jakovsola/BodyBasher/readme.txt

The Body Basher repository: everything you need to build your own affordable body biasing injection tool.
