jakovsola/BodyBasher/Firmware/readme.txt

Notes:
- build the project in release mode
- can use flash.bat to flash the Body Basher using the STM32 Programmer CLI, edit paths accordingly
