jakovsola/BodyBasher/ProductionFiles/Assembly/BOM.xlsx

Designator | Quantity | VALUE_4C | MANUFCODE | MANUF | DESCR | POPULATE
3V3, 5V, 12V, AGND, COM_N, COM_P, EN_BB, EN_MD, EN_SW, MISO, nCS, nFLT, SCK, SCL, SDA, SET, TP400, TP401, TP402, TP403, USB_M, USB_P, V_MEAS, VBUS, VCTRL, VDDIN | 26 |  | TP |  | TESTPOINT 1.5MM | NA
BOOT, COM, PULSE, TRIG, V_READY | 5 |  | 2MM-HB-S02-VT-02-H-TB | TE CONNECTIVITY | CON 2P 2MM HEADER | YES
C100 | 1 | 01N0 | 2238 600 15623 | PHYCOMP | CAP 01N0 0805 100V X7R 10% | YES
C200, C201, C202, C203, C204, C300, C301, C400, C401, C404, C405, C500, C502, C602, C605, C607, C608, C610 | 18 | 100N | CL10B104KA8WPNC | SAMSUNG | CAP 100N 0603 25V X7R 10% | YES
C205 | 1 | 04U7 | CL31B475KBHNNNE | SAMSUNG | CAP 04U7 1206 50V X7R 10% | YES
C206, C501 | 2 | 10N0 | C0603C103K8RACTU | KEMET | CAP 10N0 0603 10V X7R 10% | YES
C207, C606, C609 | 3 | 01U0 | C0603C105K4PAC-TU | KEMET | CAP 01U0 0603 16V X5R 10% | YES
C208 | 1 | 22N0 | C0603C223K8RAC7867 | KEMET | CAP 22N0 0603 10V X7R 10% | YES
C209, C210 | 2 | 15P0 | C0603C150K8RAC | KEMET | CAP 15P0 0603 10V X7R 10% | DNP
C402 | 1 | 10N0 | CGA3E2C0G1H103J080AA | TDK | CAP 10N0 0603 50V NP0 5% | YES
C403 | 1 | 33N0 | CL10B333KB8NFNC | SAMSUNG | CAP 33N0 0603 50V X7R 10% | YES
C503, C612, C618 | 3 | 01U0 | C0603C105K3PAC | KEMET | CAP 01U0 0603 25V X5R 10% | YES
C504, C505, C506, C507, C508, C509, C510, C511, C512, C513 | 10 | 01U0 | 2220CC105KAZ2A | KOYCERA | CAP 01U0 2220 600V X7R 10% | DNP
C600, C601 | 2 | 10U0 | ZRB18AR61E106ME01L | MURATA | CAP 10U0 0603 25V X5R 20% | YES
C603 | 1 | 220N | AC0603KRX7R6BB224 | YAGEO | CAP 220N 0603 10V X7R 10% | YES
C604 | 1 | 01N0 | 1206AC102KAT2A | AVX | CAP 01N0 1206 1KV X7R 10% | YES
C611 | 1 | 22U0 | CL31A226KAHNNNE | SAMSUNG | CAP 22U0 1206 25V X5R 10% | YES
C613 | 1 | 10U0 | TAJC106K025RNJ | AVX | CAP 10U0 C 25V TANT 10% | YES
C614 | 1 | 04U7 | GRM185R61C475KE11D | MURATA | CAP 04U7 0603 16V X5R 10% | YES
C615 | 1 | 56U0 | 20SVPF56MX | PANASONIC | CAP 56U0 5X5.9 20V 20% | DNP
C616 | 1 | 01U0 | C0603C105K3PAC | KEMET | CAP 01U0 0603 25V X5R 10% | DNP
C617 | 1 | 68N0 | C0603C683K8RACTU | KEMET | CAP 68N0 0603 10V X7R 10% | YES
C619, C620, C621 | 3 | 33U0 | C3216X5R1E336M160AC | TDK | CAP 33U0 1206 25V X5R 20% | YES
C622 | 1 | 56U0 | 20SVPF56MX | PANASONIC | CAP 56U0 5X5.9 20V 20% | YES
C_BANK | 1 | 10U0 | B32928A4106K000 | EPCOS | CAP 10U 30X58 650V PP 10% | YES
CON_PWR | 1 |  | 1711725 | PHOENIX CONTACT | CON PHOENIX 5.08MM 2P SCREW | YES
D1, D2, PWR | 3 |  | ASMT-RF45 | AVAGO TECHNOLOGIES | LED GREEN 0603 20MA 2.4V 60MCD | YES
D601 | 1 |  | RS2K-E3/52T | VISHAY | DIODE 800V 1.5A SMB | YES
IC200 | 1 |  | STM32F072CBT6 | STM | IC MCU ARM CORTEX-M0 128KB 48MHZ USB | YES
IC300 | 1 |  | SN74LVC257APWR | TI | IC MUX QUAD 2:1 3 STATE | YES
IC301 | 1 |  | 74LVC1GU04GW,125 | NEXPERIA | IC INV SINGLE UNBUFFERED | YES
IC400, IC401 | 2 |  | ISO7741FBDW | TI | IC ISO 3/1 100MBPS 2.25-5.5 V | YES
IC402 | 1 |  | LMG2610RRGT | TEXAS INSTRUMENTS | IC INT HALF BRIDGE GAN | YES
IC403, IC404 | 2 |  | CPC1981Y | IXYS | IC SSR SPST NO 1000V 180mA | YES
IC500 | 1 |  | PLB171P | IXYS | IC SSR SPST NC 800V 80mA | YES
IC501 | 1 |  | ADC101S051CIMF/NOPB | TI | IC ADC 10B 500KSPS SPI | YES
IC502 | 1 |  | OPA310IDCKR | TI | IC OPAMP 5.5V 3MHz | YES
IC600 | 1 |  | MIC2954-03WS-TR | MICROCHIP | IC LDO 2-30VIN 5VOUT 250mA | YES
IC601 | 1 |  | TPS55289RYQR | TI | IC BUCK-BOOST 30V 8A I2C | YES
L600 | 1 |  | SRN8040-4R7Y | BOURNS | INDUCTOR 04U7 4A1 R024 SMD | YES
PIN | 1 |  | P25-0123 | HARWIN | POGO PIN 15X5MM | YES
R100 | 1 | 33K0 | CRCW060333K0FKEA | VISHAY | RES 33K0 0603 0.1W 1% 75V 100PPM | YES
R101, R102, R105 | 3 | 33R0 | CRCW060333R0FKEA | VISHAY | RES 33R0 0603 0.1W 1% 75V 100PPM | YES
R103 | 1 | 82K0 | CRCW060382K0FKEA | VISHAY | RES 82K0 0603 0.1W 1% 75V 100PPM | YES
R104 | 1 | 01M0 | MC 0.063W 0603 1% 1M | MULTICOMP | RES 01M0 0603 0.063W 1% 50V 100PPM | YES
R200, R201 | 2 | 10K0 | CRCW060310K0FKEA | VISHAY | RES 10K0 0603 0.1W 1% 75V 100PPM | YES
R202 | 1 | 13K3 | CRCW060313K3FKEA | VISHAY | RES 13K3 0603 0.1W 1% 75V 100PPM | YES
R203, R204, R206, R207 | 4 | 01K0 | MC 0.063W 0603 1% 1K | MULTICOMP | RES 01K0 0603 0.063W 1% 50V 100PPM | YES
R205 | 1 | 05K1 | RC0603FR-075K1L | YAGEO | RES 05K1 0603 0.1W 1% 75V 100PPM | YES
R208, R209, R210 | 3 | 000R | CRCW06030000Z0EA | VISHAY | RES 000R 0603 0.1W 1% 75V 100PPM | DNP
R211 | 1 | 470R | ERA3AEB471V | PANASONIC | RES 470R 0603 0.1W 0.1% 75V 25PPM | DNP
R400 | 1 | 05K1 | MC 0.063W 0603 1% 5K1 | MULTICOMP | RES 05K1 0603 0.063W 1% 50V 100PPM | YES
R401, R402 | 2 | 05K6 | MC 0.063W 0603 1% 5K6 | MULTICOMP | RES 05K6 0603 0.063W 1% 50V 100PPM | YES
R403, R404, R500 | 3 | 120R | CRCW0603120RFKEA | VISHAY | RES 120R 0603 0.1W 1% 75V 100PPM | YES
R501 | 1 | 100M | CRHA1210AF100MFKEF | VISHAY | RES 100M 1210 0.45W 1% 1750V 100PPM | YES
R502 | 1 | 01M0 | RCV12061M00FKEAAT | VISHAY | RES 1M 1210 0.25W 1% 800V 100PPM | YES
R600 | 1 | 04K7 | CRCW06034K70JNEAC | VISHAY | RES 04K7 0603 0.1W 5% 75V 200PPM | YES
R601 | 1 | 680K | CRCW0603680KFKEA | VISHAY | RES 680K 0603 0.1W 1% 75V 100PPM | DNP
R602 | 1 | 100K | MC 0.063W 0603 1% 100K | MULTICOMP | RES 100K 0603 0.063W 1% 50V 100PPM | YES
R603 | 1 | 10K5 | MC0063W0603110K5 | MULTICOMP | RES 10K5 0603 0.063W 1% 50V 100PPM | YES
R604 | 1 | 000R | CRCW06030000Z0EA | VISHAY | RES 000R 0603 0.1W 1% 75V 100PPM | YES
R605 | 1 | 100K | MC 0.063W 0603 1% 100K | MULTICOMP | RES 100K 0603 0.063W 1% 50V 100PPM | DNP
R606 | 1 | 47K0 | CRCW060347K0FKEA | VISHAY | RES 47K0 0603 0.1W 1% 75V 100PPM | YES
R607 | 1 | 1K10 | CRCW06031K10FKEA | VISHAY | RES 1K10 0603 0.1W 1% 75V 100PPM | DNP
R608 | 1 | 4K99 | MC 0.063W 0603 1% 4K99 | MULTICOMP | RES 4K99 0603 0.1W 1% 50V 100PPM | YES
R_BLEED | 1 | 25K0 | RS01025K00FE73 | VISHAY | RES 25K AXIAL 10W 1% 20PPM | YES
RST | 1 |  | FSM2JSMAATR | TE CONNECTIVITY | BTN 24V 4P SMD | YES
TR600 | 1 |  | TMR 1-1212 | TRACO | IC TR 9-18 VIN 12 VOUT REG ISO 1W | YES
TR601 | 1 |  | TSR 0.5-2433 | TRACO | IC TR 4.75-32 VIN 3.3 VOUT 0.5A | YES
TR602 | 1 |  | TDU 1-1212 | TRACO | IC TR 10.8-13.2 VIN 12 VOUT ISO 1W | YES
TVS100 | 1 |  | SP3003-02JTG | LITTELFUSE | DIODE TVS DUAL 0.65PF SC70-5 | YES
USB | 1 |  | 47642-0001 | MOLEX | CON MICRO USB 5P SMD | YES
X200 | 1 |  | ABS07-32.768KHZ-7-T | ABRACON | CRYSTAL 32.768KHZ 7PF 20PPM SMD | DNP
X201 | 1 |  | FC3BAEBDI8.0-T1 | ABRACON | CRYSTAL 8MHZ 8PF 20PPM SMD | DNP
XP600 | 1 |  | F05 | XP POWER | IC DCDC 0.8-12VIN 0-500 VOUT 10W | YES
