jakovsola/BodyBasher/Documents/Schematic.pdf

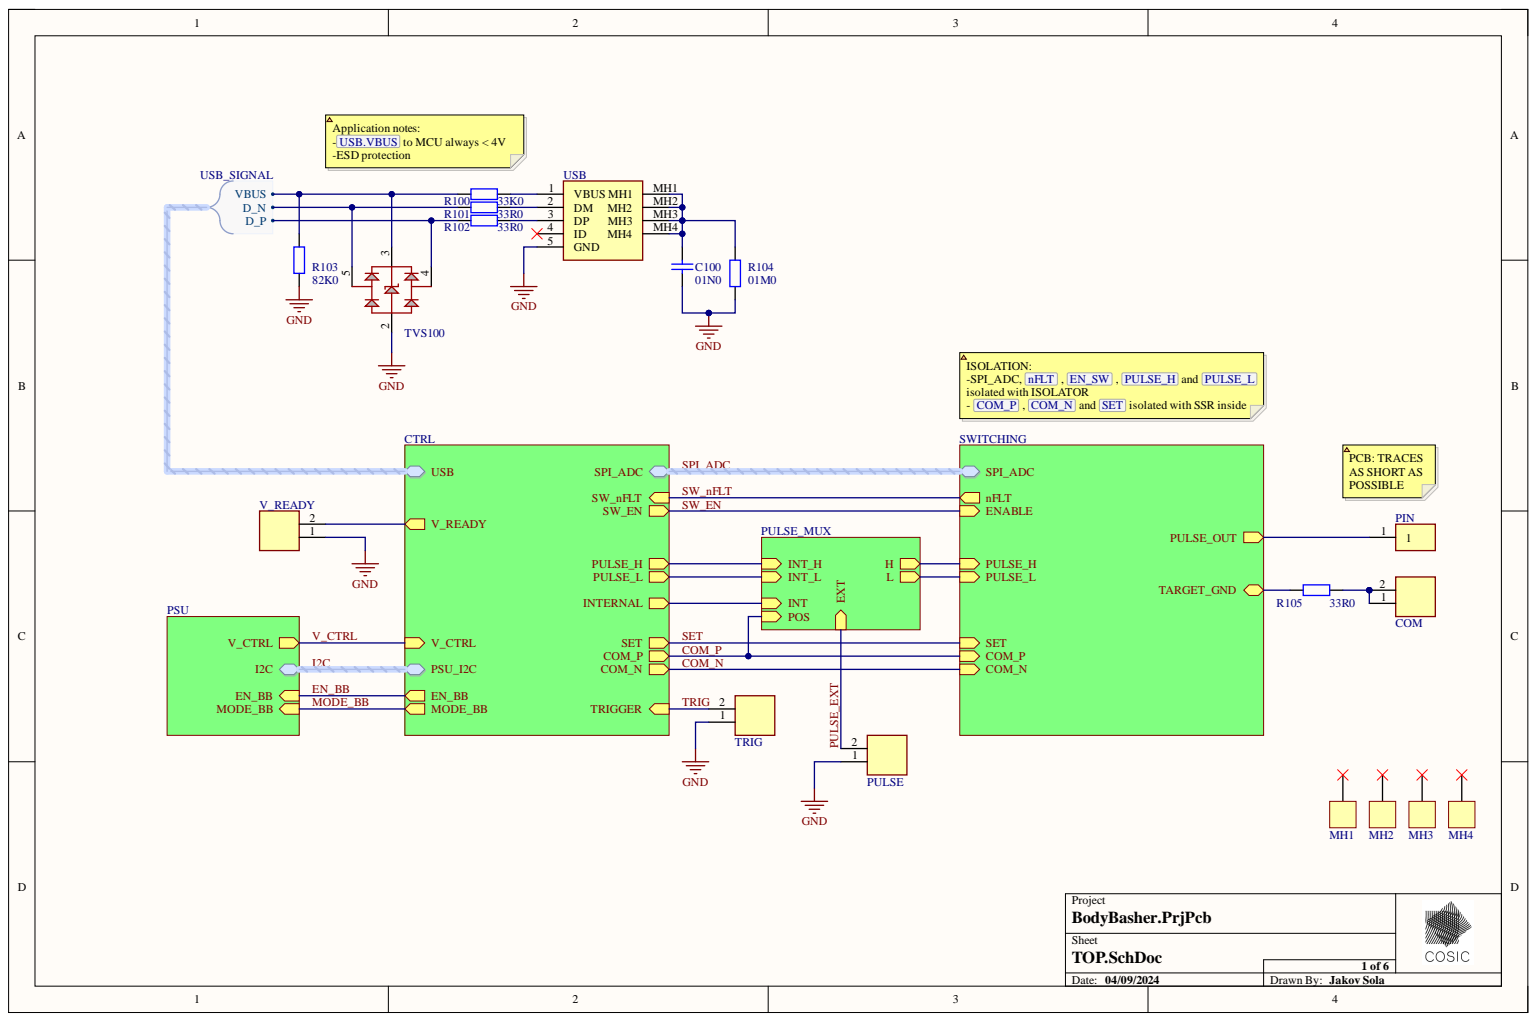
[picture p2: page 1]

Application notes:
- USB.VBUS to MCU always < 4V
-ESD protection

ISOLATION:
-SPI_ADC, nFLT , EN_SW , PULSE_H and PULSE_L
isolated with ISOLATOR
- COM_P , COM_N and SET isolated with SSR inside

I2C | COM_P

COM_N

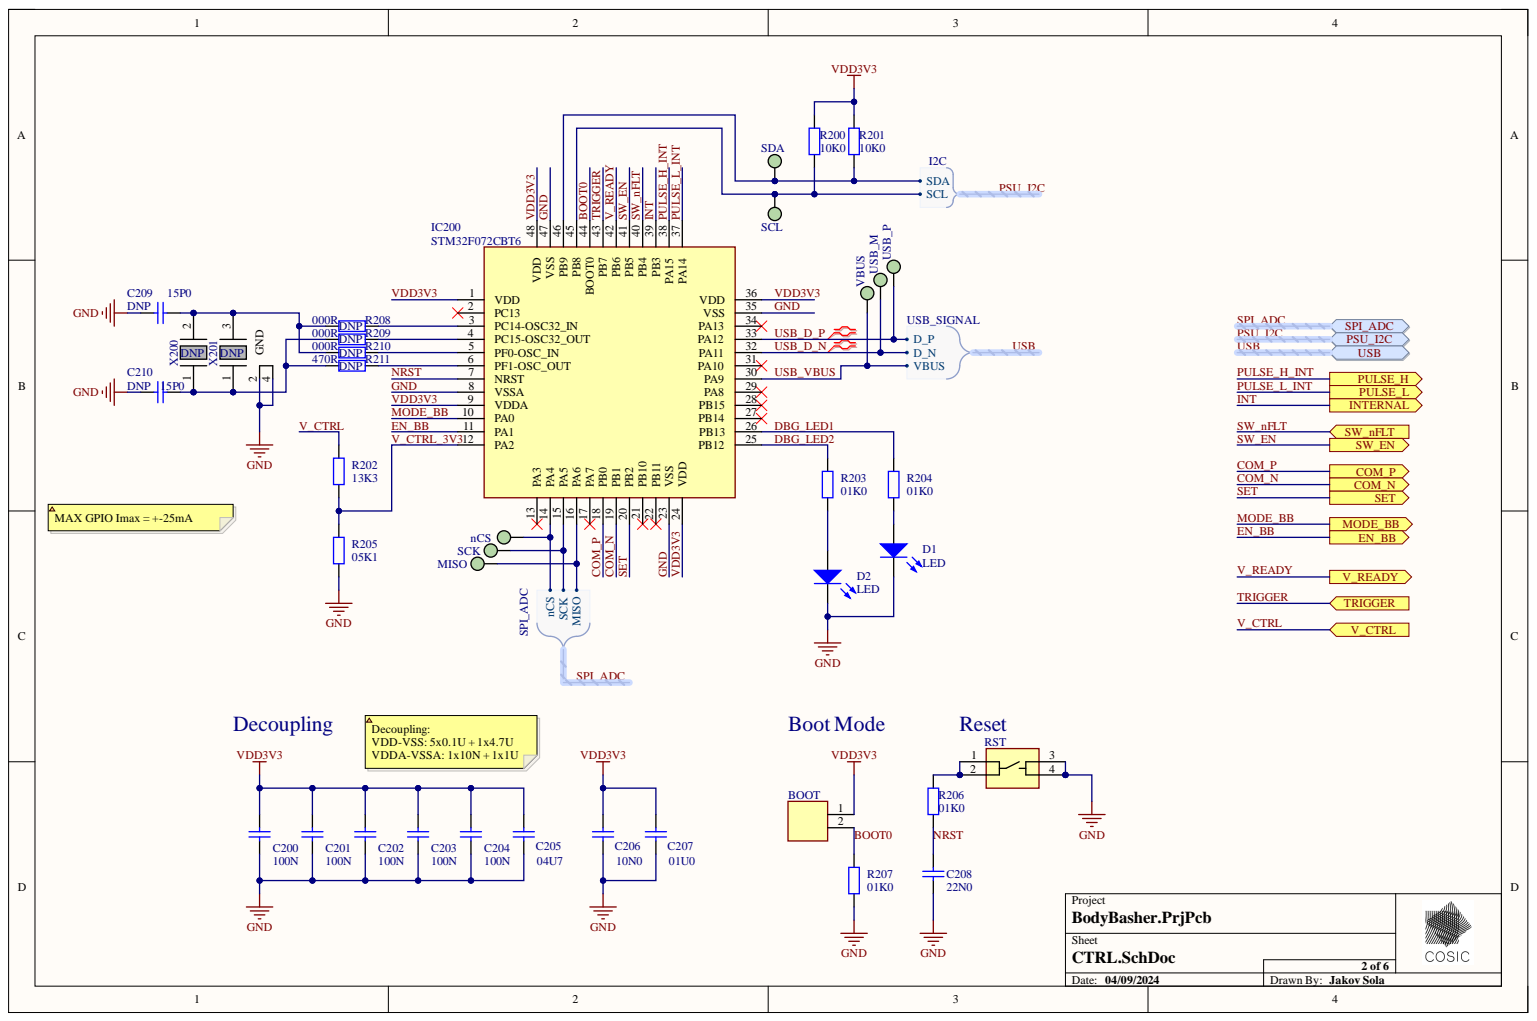
[picture p3: page 2]

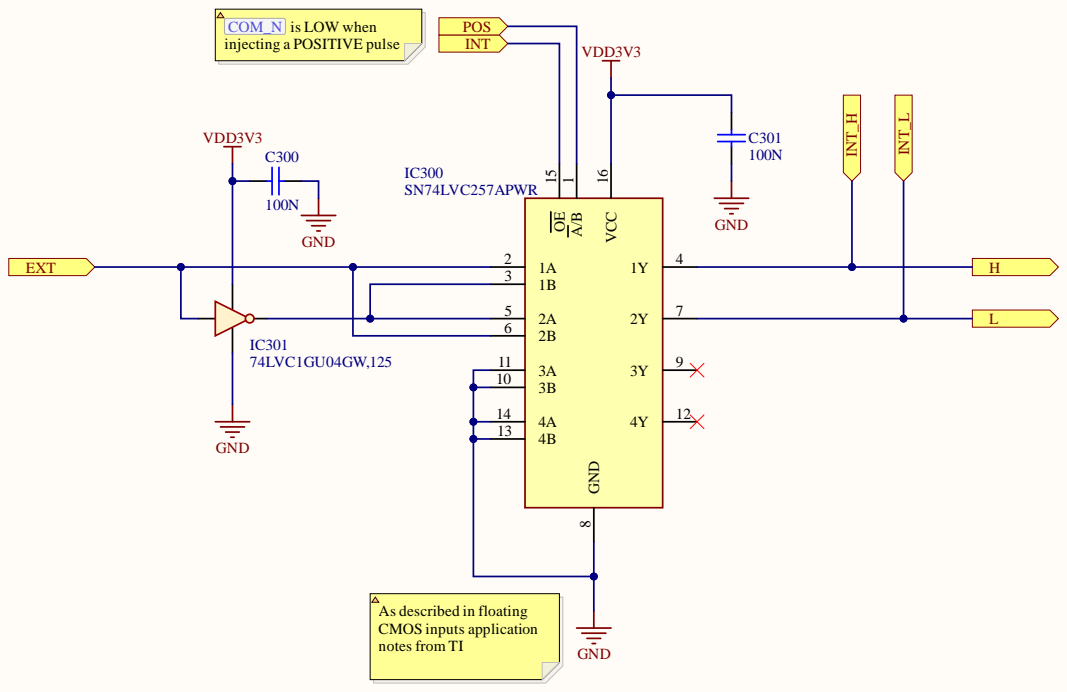
[picture p4: page 3]

As described in floating
CMOS inputs application
notes from TI

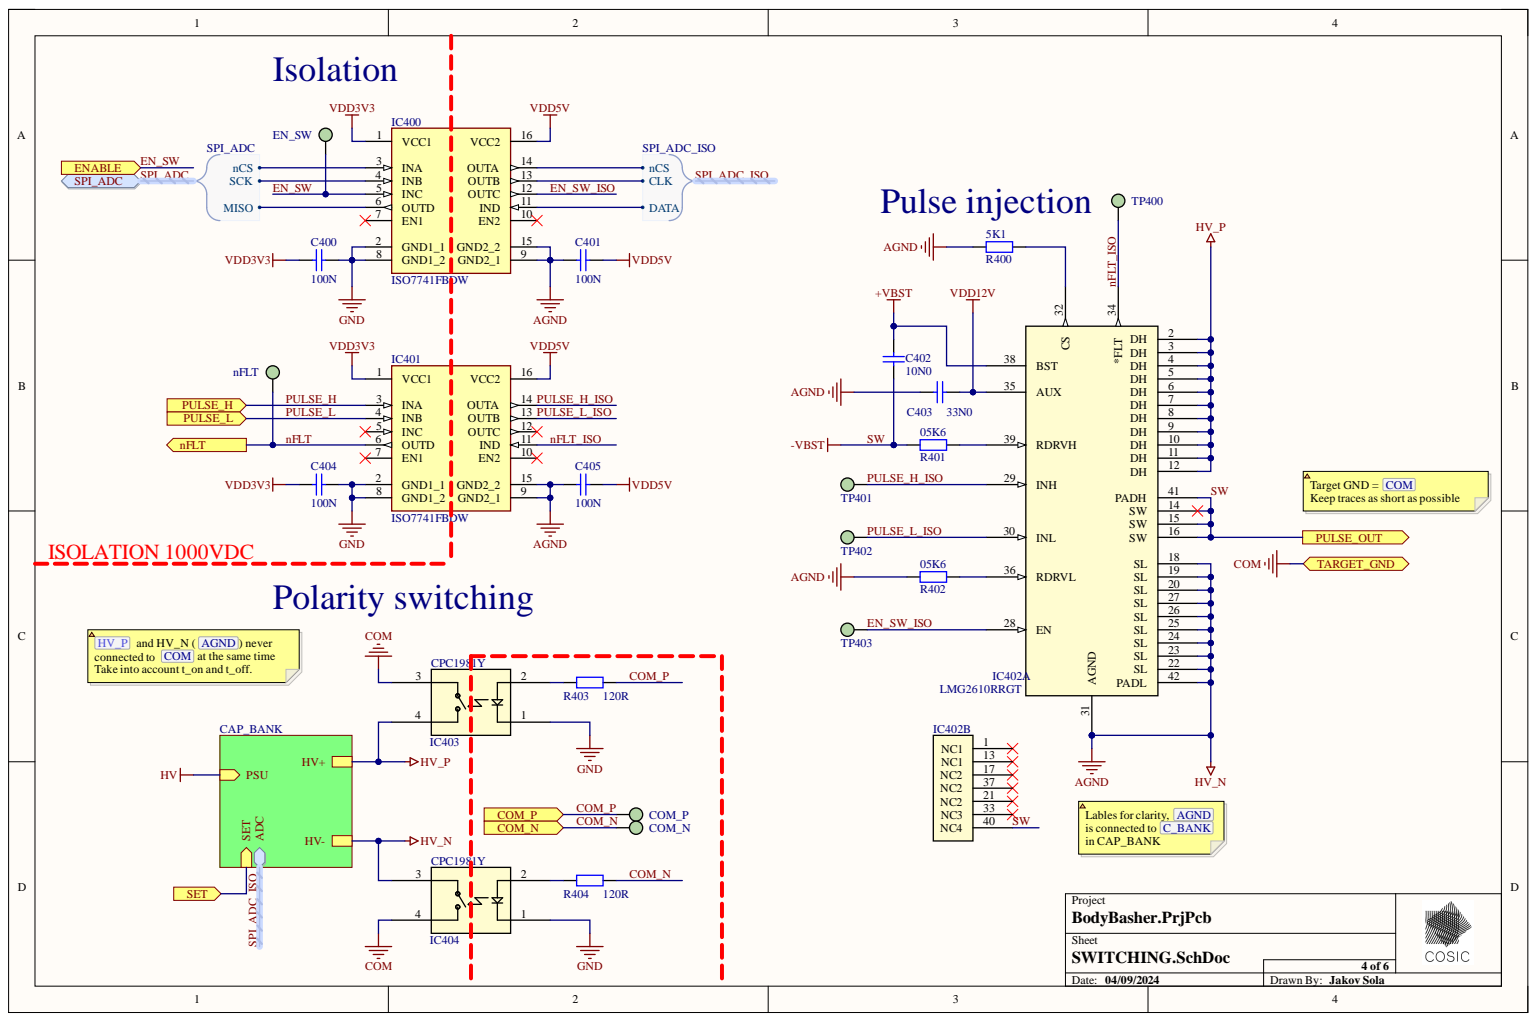
[picture p5: page 4]

Target GND = COM
Keep traces as short as possible

HV_P and HV_N ( AGND ) never
connected to COM at the same time
Take into account t_on and t_off.

Lables for clarity, AGND
is connected to C_BANK
in CAP_BANK

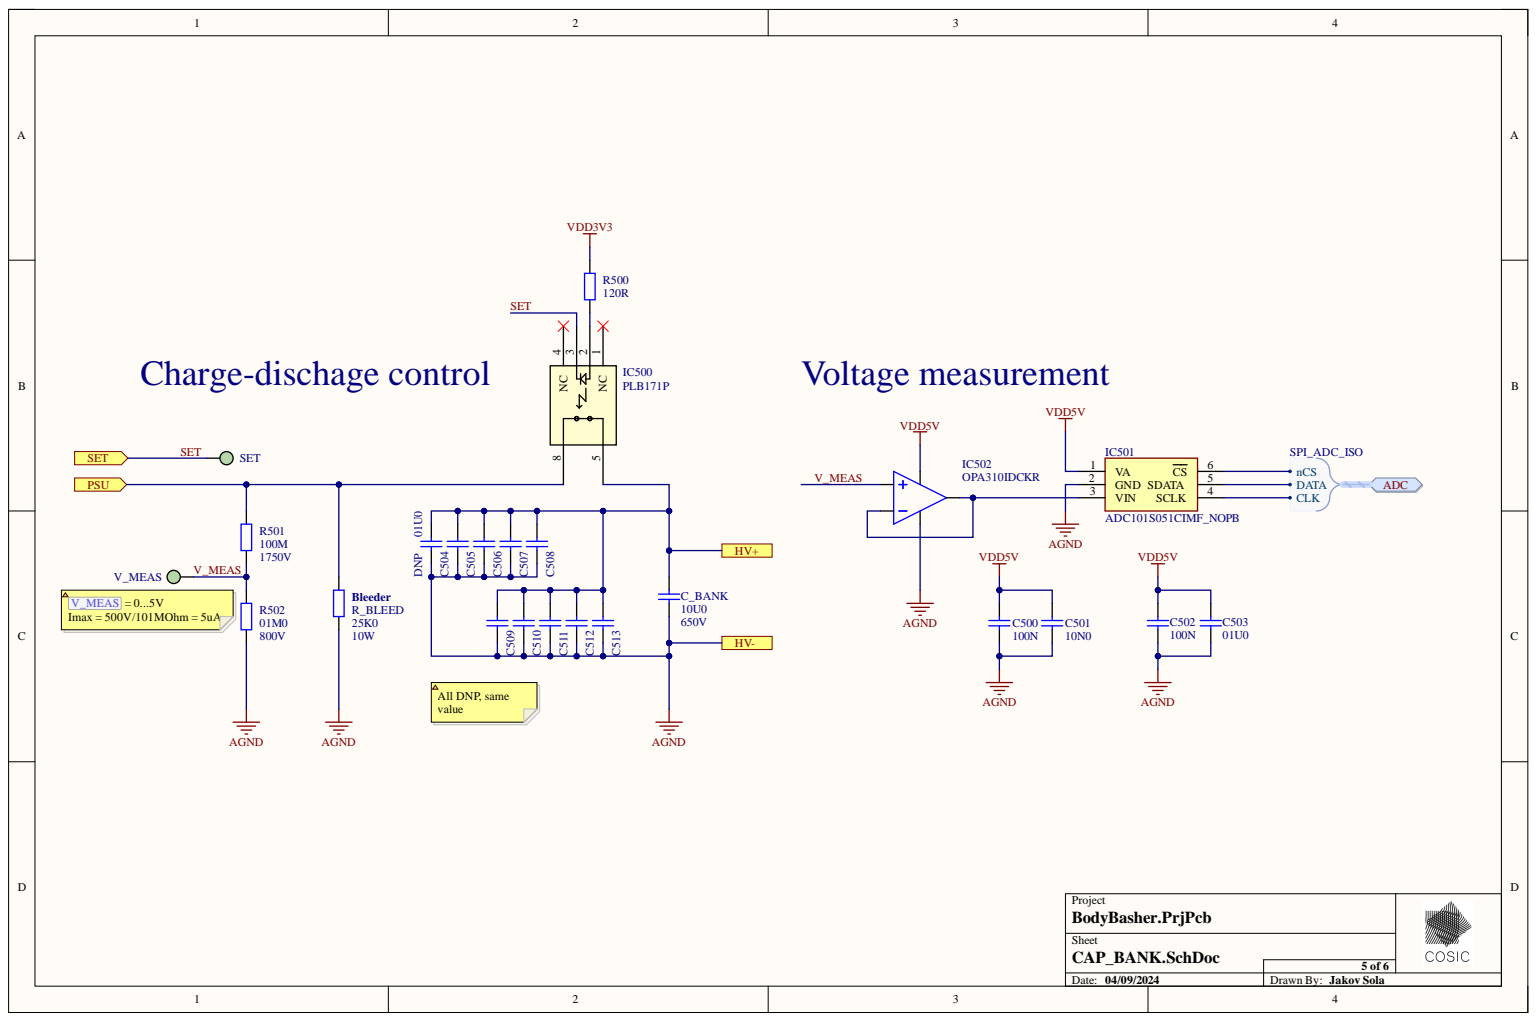
[picture p6: page 5]

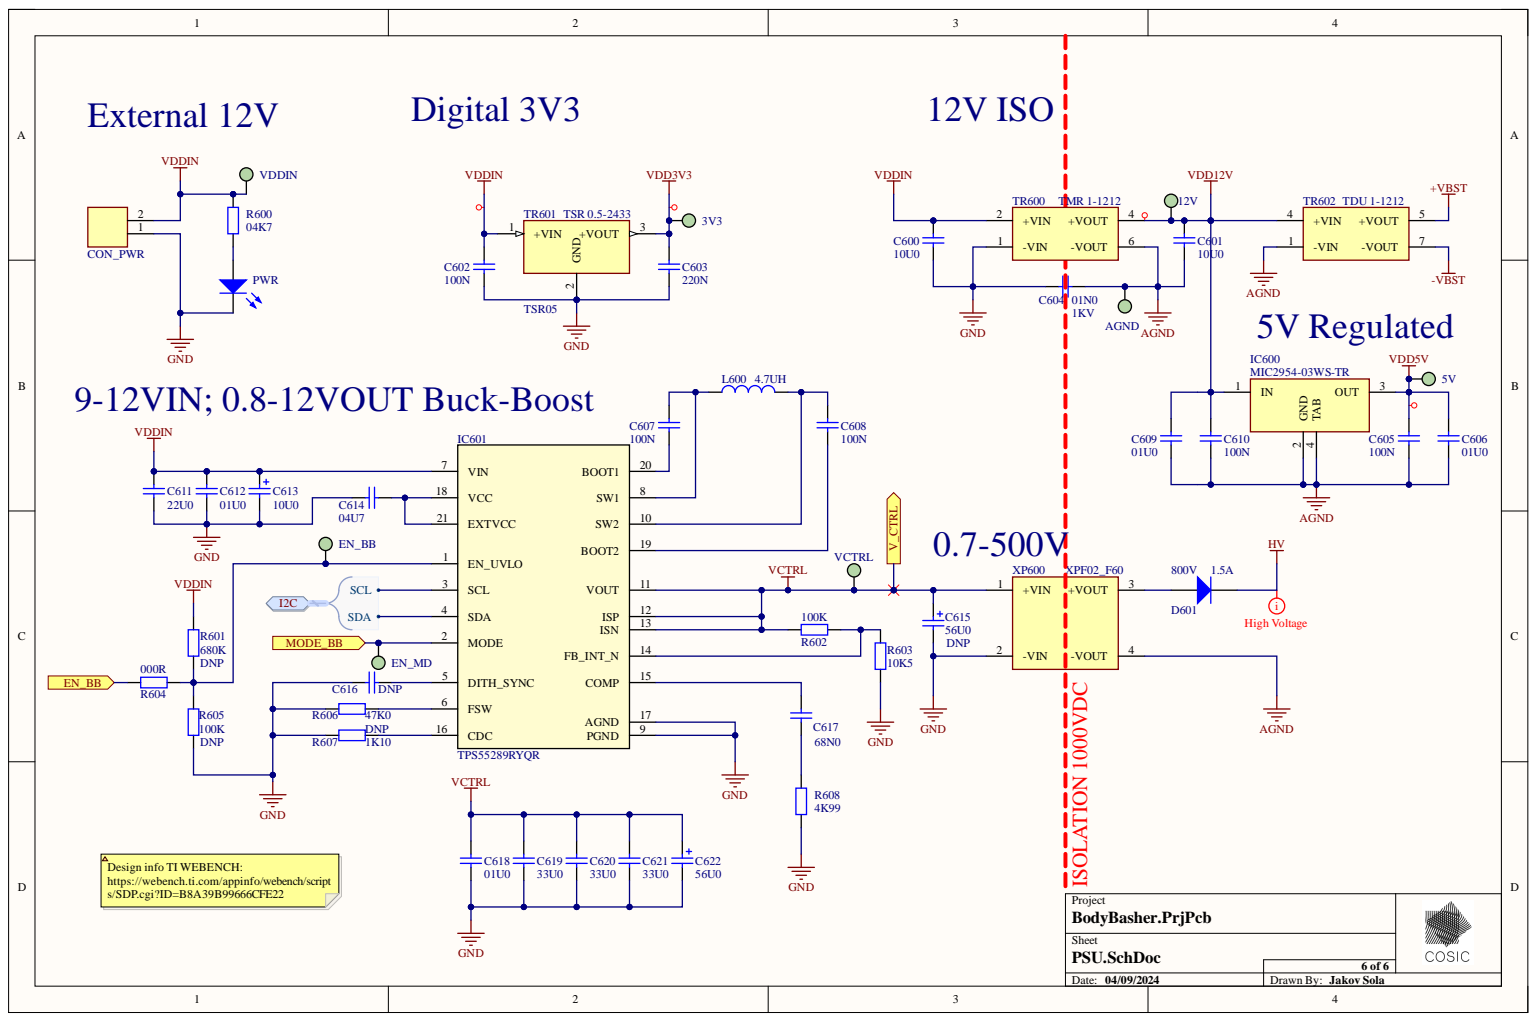
[picture p7: page 6]

Design info TI WEBENCH:
https://webench.ti.com/appinfo/webench/script
s/SDP.cgi?ID=B8A39B99666CFE22
