jakovsola/BodyBasher/(list of files, drawings)

Other design files:
Altium/BodyBasher.PrjPcb
Altium/CAP_BANK.SchDoc
Altium/CTRL.SchDoc
Altium/PCB.PcbDoc
Altium/PSU.SchDoc
Altium/PULSE_MUX.SchDoc
Altium/SWITCHING.SchDoc
Altium/SWITCHING_OLD.SchDoc
Altium/TOP.SchDoc
