jakovsola/BodyBasher/Firmware/Core/Src/main.c

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
/* Includes ------------------------------------------------------------------*/
#include "main.h"
#include "usb_device.h"

/* USER CODE BEGIN Includes */
#include "usbd_cdc_if.h"
#include "terminal.h"
#include "fsm.h"
#include "utils.h"
/* USER CODE END Includes */

ADC_HandleTypeDef hadc;
DMA_HandleTypeDef hdma_adc;

I2C_HandleTypeDef hi2c1;

SPI_HandleTypeDef hspi1;

TIM_HandleTypeDef htim2;
TIM_HandleTypeDef htim3;

WWDG_HandleTypeDef hwwdg;

void SystemClock_Config(void);
static void MX_GPIO_Init(void);
static void MX_DMA_Init(void);
static void MX_ADC_Init(void);
static void MX_I2C1_Init(void);
static void MX_SPI1_Init(void);
static void MX_TIM3_Init(void);
static void MX_TIM2_Init(void);
static void MX_WWDG_Init(void);
/* USER CODE BEGIN 0 */
STATE state = ST_IDLE;
EVENT event = EV_NULL;
uint8_t errorCode = 0x00;

/* USER CODE END 0 */

/**
  * @brief  The application entry point.
  * @retval int
  */
int main(void)
{
  /* MCU Configuration--------------------------------------------------------*/

  /* Reset of all peripherals, Initializes the Flash interface and the Systick. */
  HAL_Init();

  /* Configure the system clock */
  SystemClock_Config();

  /* Initialize all configured peripherals */
  MX_GPIO_Init();
  MX_DMA_Init();
  MX_ADC_Init();
  MX_I2C1_Init();
  MX_SPI1_Init();
  MX_USB_DEVICE_Init();
  MX_TIM3_Init();
  MX_TIM2_Init();
//  MX_WWDG_Init();
  /* USER CODE BEGIN 2 */
    HAL_Delay(1000); //wait 1s for everyting to initialise
    toIdle(); //initialise device to idle state
    HAL_ADCEx_Calibration_Start(&hadc); //self-calibration of the on-chip ADC

    HAL_SPI_Receive(&hspi1, NULL, 1, 100); //start field-side ADC to normal mode
  /* USER CODE END 2 */

  /* Infinite loop */
  /* USER CODE BEGIN WHILE */
    MX_WWDG_Init();
    initTerminal(); //initialise terminal and print logo
    printPrompt();  //print first prompt
    while (1)
    {
    /* USER CODE END WHILE */

    /* USER CODE BEGIN 3 */
    	HAL_WWDG_Refresh(&hwwdg);
    	checkTerminal();
        switch (state) {
            case ST_IDLE:
//            	HAL_WWDG_Refresh(&hwwdg);
                //transitions
                switch (event) {
                    case EV_ARM:
//                        printArm();
                        toArming();
                        state = ST_ARMING;
                        break;
                    case EV_ERROR:
                        toError();
                        state = ST_ERROR;
                        break;
                    case EV_NULL:
                        break;
                    default:
                        printInvalid();
                        break;
                }
                break;
            case ST_ARMING:
                //transitions
                switch (event) {
                    case EV_DISARM:
//                        printDisarm();
                        toIdle();
                        state = ST_IDLE;
                        break;
                    case EV_VOLTAGE_READY:
                        toArmed();
                        state = ST_ARMED;
                        break;
                    case EV_ERROR:
//                        printDisarm();
                        toError();
                        state = ST_ERROR;
                        break;
                    case EV_NULL:
                        break;
                    default:
                        printInvalid();
                        break;
                }

                //Disable and reset timers used only in the arming state
                if (state != ST_ARMING){
                    HAL_TIM_Base_Stop_IT(&htim3);
                    __HAL_TIM_SET_COUNTER(&htim3, 0);
                    HAL_TIM_Base_Stop_IT(&htim2);
                    __HAL_TIM_SET_COUNTER(&htim2, 0);
                }
                break;
            case ST_ARMED:
                //transitions
                switch (event) {
                    case EV_ARM:
//                        printArm();
                        toArming();
                        state = ST_ARMING;
                        break;
                    case EV_DISARM:
//                        printDisarm();
                        toIdle();
                        state = ST_IDLE;
                        break;
                    case EV_ERROR:
//                        printDisarm();
                        toError();
                        state = ST_ERROR;
                        break;
                    case EV_NULL:
                        break;
                    default:
                        printInvalid();
                        break;
                }
                break;
//            case ST_INJECTING:
//
//                break;
            case ST_ERROR:
                //transitions
                switch (event) {
                    case EV_CLEAR_ERRROR:
                        toIdle();
                        state = ST_IDLE;
                        break;
                    case EV_NULL:
                        break;
                    case EV_ERROR:
                        toError();
                        state = ST_ERROR;
                        break;
                    default:
                        printInvalid();
                        break;
                }
                break;
            default:

                break;
        }
        event = EV_NULL;

    }
  /* USER CODE END 3 */
}

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
