jakovsola/BodyBasher/Firmware/Core/Inc/main.h

#define MODE_BB_Pin GPIO_PIN_0
#define MODE_BB_GPIO_Port GPIOA
#define EN_BB_Pin GPIO_PIN_1
#define EN_BB_GPIO_Port GPIOA
#define V_CTRL_Pin GPIO_PIN_2
#define V_CTRL_GPIO_Port GPIOA
#define COM_P_Pin GPIO_PIN_0
#define COM_P_GPIO_Port GPIOB
#define COM_N_Pin GPIO_PIN_1
#define COM_N_GPIO_Port GPIOB
#define SET_Pin GPIO_PIN_2
#define SET_GPIO_Port GPIOB
#define LD2_Pin GPIO_PIN_12
#define LD2_GPIO_Port GPIOB
#define LD1_Pin GPIO_PIN_13
#define LD1_GPIO_Port GPIOB
#define PULSE_L_Pin GPIO_PIN_14
#define PULSE_L_GPIO_Port GPIOA
#define PULSE_H_Pin GPIO_PIN_15
#define PULSE_H_GPIO_Port GPIOA
#define INT_Pin GPIO_PIN_3
#define INT_GPIO_Port GPIOB
#define SW_nFLT_Pin GPIO_PIN_4
#define SW_nFLT_GPIO_Port GPIOB
#define SW_nFLT_EXTI_IRQn EXTI4_15_IRQn
#define SW_EN_Pin GPIO_PIN_5
#define SW_EN_GPIO_Port GPIOB
#define V_READY_Pin GPIO_PIN_6
#define V_READY_GPIO_Port GPIOB
#define TRIGGER_Pin GPIO_PIN_7
#define TRIGGER_GPIO_Port GPIOB
#define BB_ADDR 0x75 << 1
#define TRUE 1
#define FALSE 0
#define NEGATIVE 0
#define POSITIVE 1
#define ER_TIMEOUT 0x01 << 0;
#define ER_OVERVOLTAGE 0x01 << 1;
#define ER_LMG_FAULT 0x01 << 2;
